jlee167/usb-cam-schematic/guardianCam_Wifi.kicad_pcb

## KiCad design guardianCam_Wifi.kicad_pcb (2021-04-28)

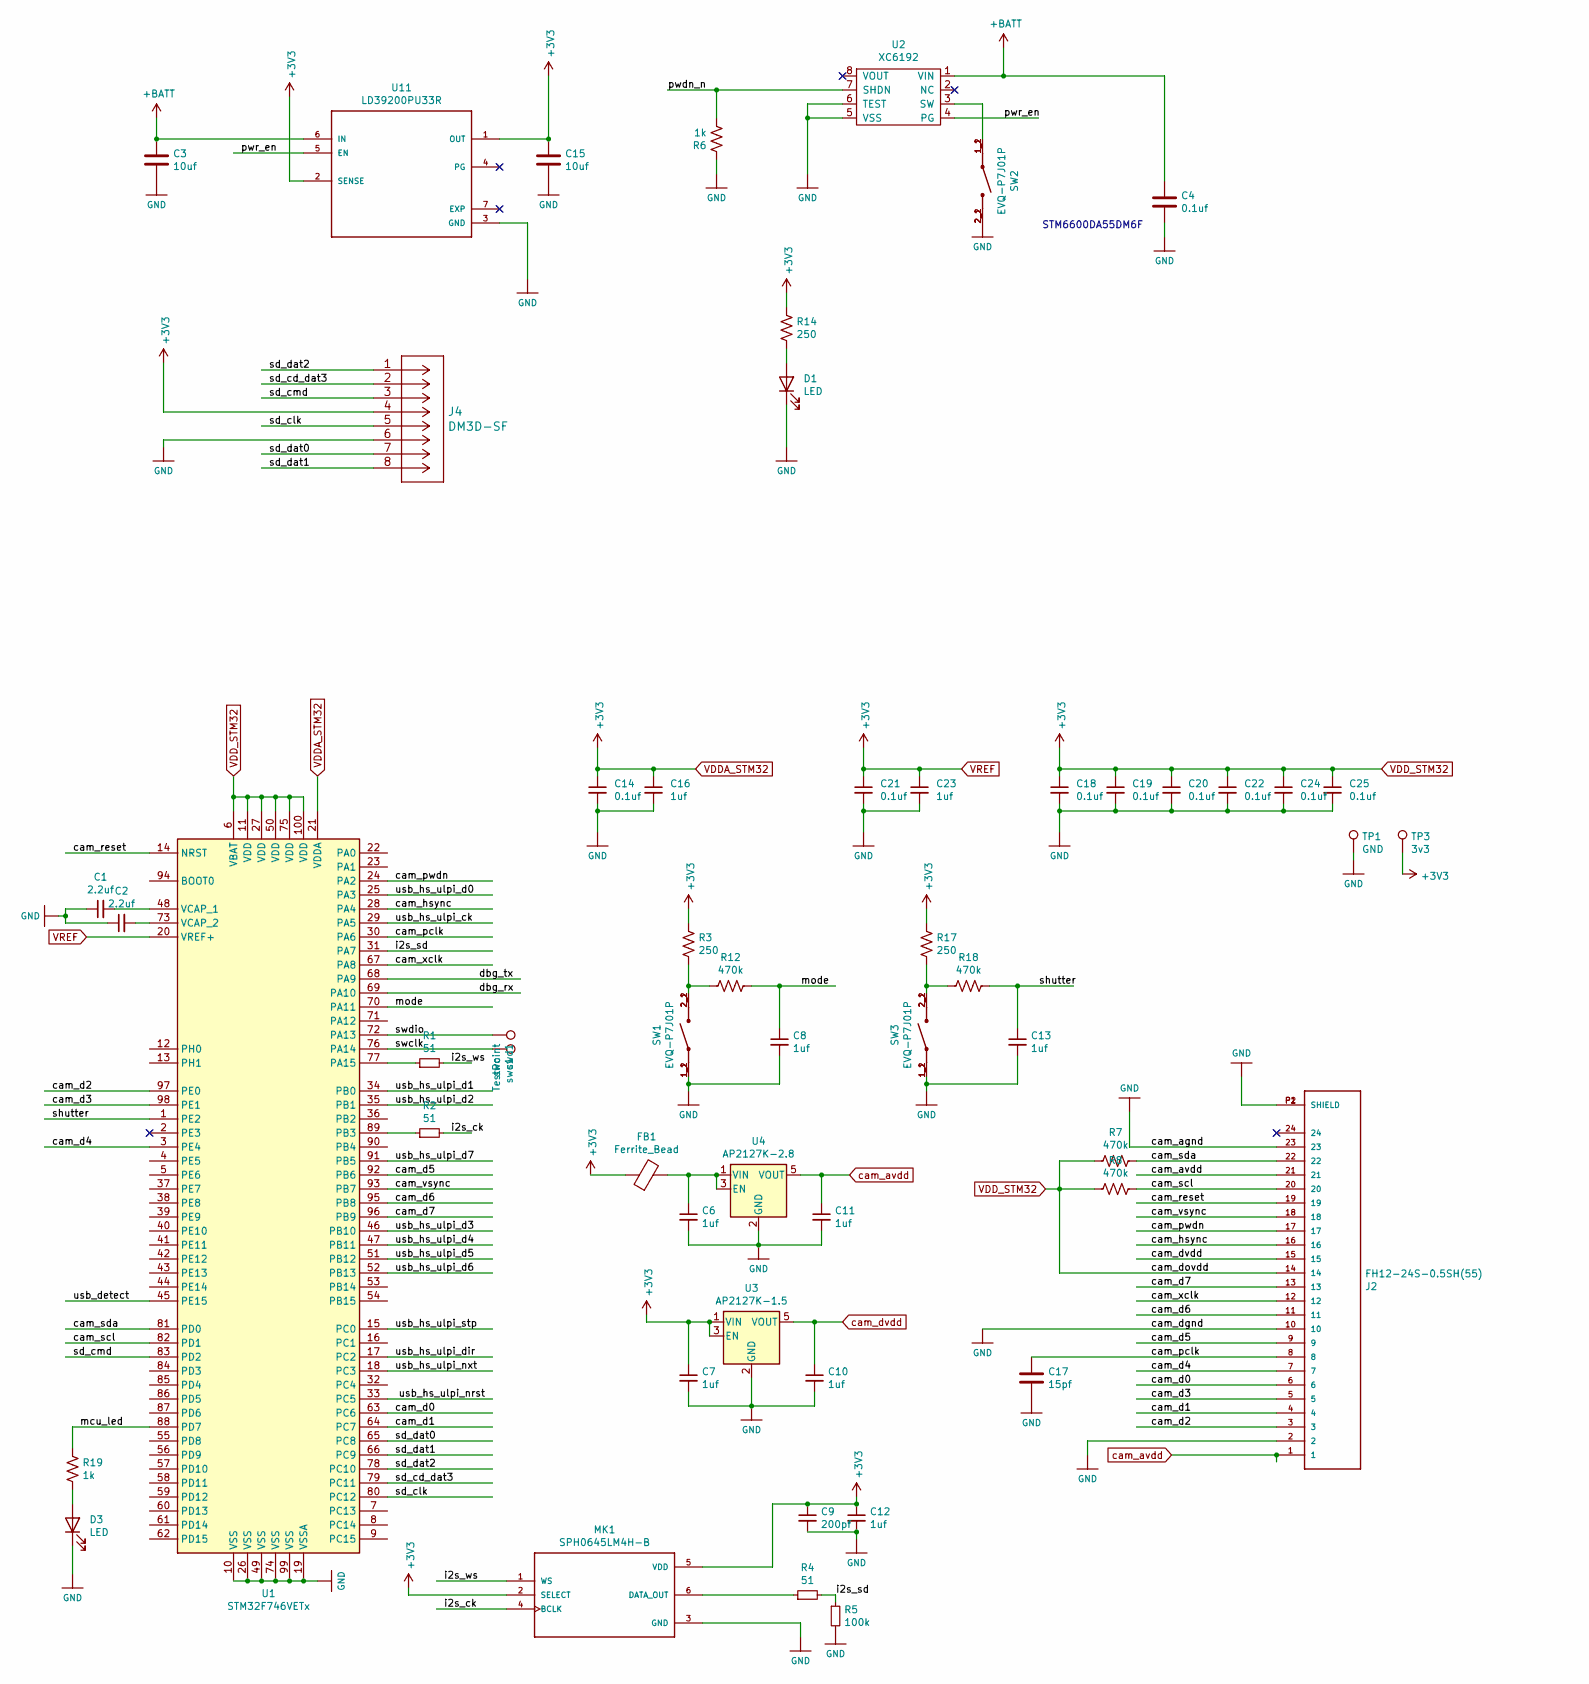
[picture p1: schematic guardianCam_Wifi.sch, part in row 1, column 1]

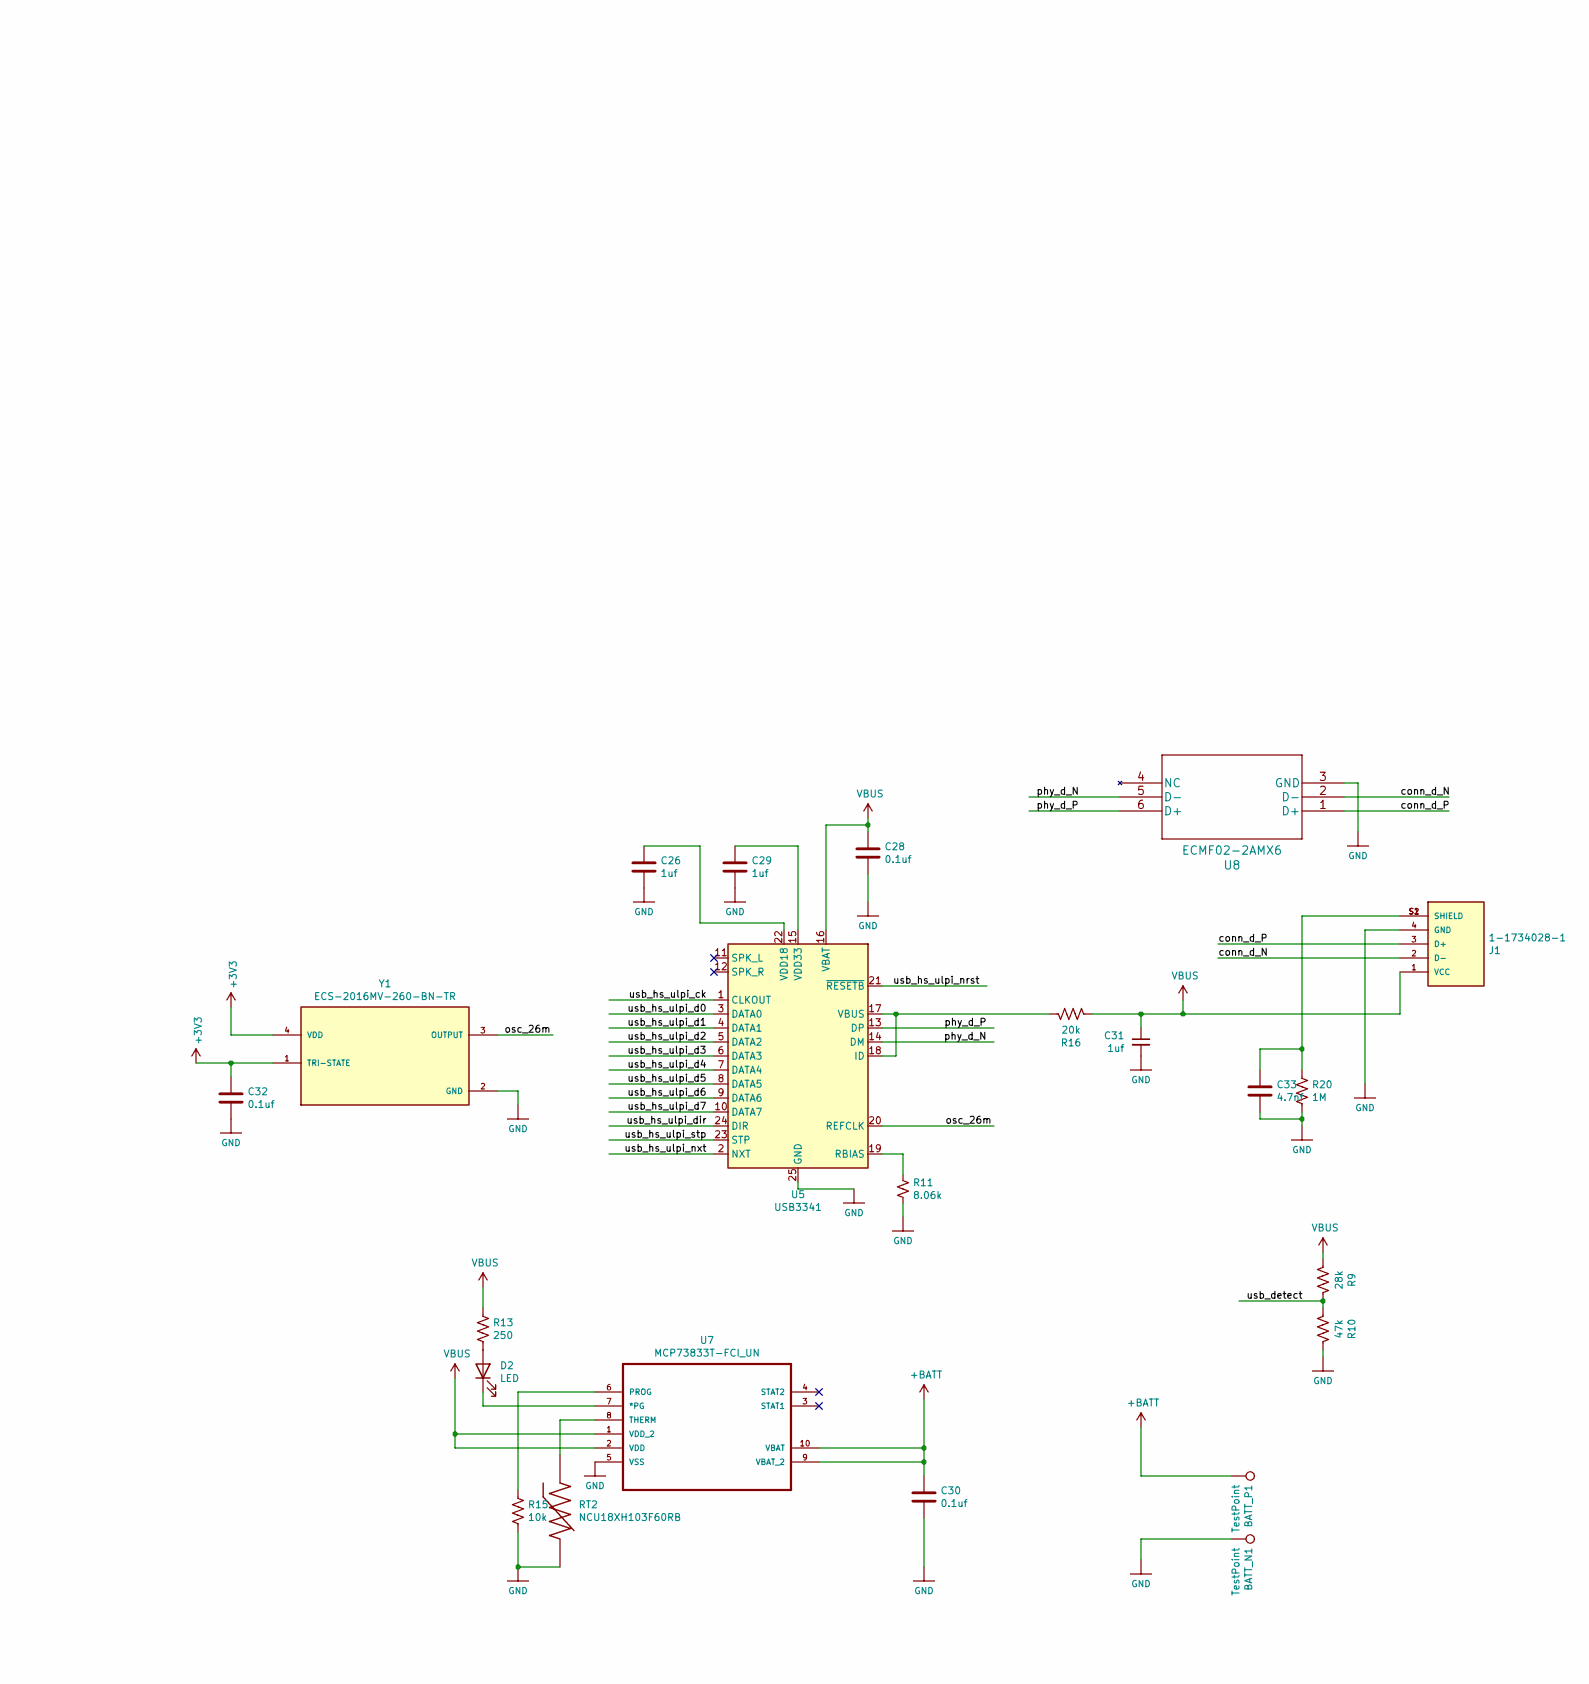
[picture p2: schematic guardianCam_Wifi.sch, part in row 1, column 2]

Parts:
BATT_N1: TestPoint; TestPoint_THTPad_1.0x1.0mm_Drill0.5mm
BATT_P1: TestPoint; TestPoint_THTPad_D1.0mm_Drill0.5mm
C1, C2: 2.2uf; C_0603_1608Metric_Pad1.05x0.95mm_HandSolder
C3, C15: 10uf; C_0603_1608Metric_Pad1.05x0.95mm_HandSolder
C4, C14, C18, C19, C20, C21, C22, C24, C25, C32: 0.1uf; C_0402_1005Metric
C6, C7, C8, C10, C11, C12, C13, C31: 1uf; C_0603_1608Metric_Pad1.05x0.95mm_HandSolder
C9: 200pf; C_0603_1608Metric_Pad1.05x0.95mm_HandSolder
C16, C23, C26, C29: 1uf; C_0402_1005Metric
C17: 15pf; C_0603_1608Metric_Pad1.05x0.95mm_HandSolder
C28: 0.1uf; C_0603_1608Metric_Pad1.05x0.95mm_HandSolder
C30: 0.1uf; C_0805_2012Metric_Pad1.15x1.40mm_HandSolder
C33: 4.7nf; C_0402_1005Metric
D1, D2, D3: LED; LED_0402_1005Metric
FB1: Ferrite_Bead; FB_MPZ2012S601ATD25
J1: 1-1734028-1; TE_1-1734028-1
J2: FH12-24S-0.5SH(55); HRS_FH12-24S-0.5SH(55)
J4: DM3D-SF
MK1: SPH0645LM4H-B; MIC_SPH0645LM4H-B
R1: 51; R_0402_1005Metric
R2, R4: 51; R_0603_1608Metric_Pad1.05x0.95mm_HandSolder
R3, R17: 250; R_0603_1608Metric_Pad1.05x0.95mm_HandSolder
R5: 100k; R_0603_1608Metric_Pad1.05x0.95mm_HandSolder
R6, R19: 1k; R_0402_1005Metric
R7, R8, R12, R18: 470k; R_0603_1608Metric_Pad1.05x0.95mm_HandSolder
R9: 28k; R_0603_1608Metric_Pad1.05x0.95mm_HandSolder
R10: 47k; R_0603_1608Metric_Pad1.05x0.95mm_HandSolder
R11: 8.06k; R_0402_1005Metric
R13, R14: 250; R_0402_1005Metric
R15: 10k; R_0402_1005Metric
R16: 20k; R_0603_1608Metric_Pad1.05x0.95mm_HandSolder
R20: 1M; R_0402_1005Metric
RT2: NCU18XH103F60RB
SW1, SW2, SW3: EVQ-P7J01P
TP1: GND; TestPoint_Pad_1.5x1.5mm
TP3: 3v3; TestPoint_Pad_1.5x1.5mm
U1: STM32F746VETx; LQFP-100_14x14mm_P0.5mm
U2: XC6192; xc6192
U3: AP2127K-1.5; SOT-23-5
U4: AP2127K-2.8; SOT-23-5
U5: USB3341; QFN-24-1EP_4x4mm_P0.5mm_EP2.6x2.6mm
U7: MCP73833T-FCI_UN
U8: ECMF02-2AMX6
U11: LD39200PU33R
Y1: ECS-2016MV-260-BN-TR; OSC_ECS-2016MV-260-BN-TR
swc1: swc; TestPoint_Pad_1.5x1.5mm
swd1: TestPoint; TestPoint_Pad_1.5x1.5mm

Connections:
+BATT: BATT_P1.1, C3.1, C4.1, C30.1, U2.1 (VIN), U7.9 (VBAT_2), U7.10 (VBAT), U11.6 (IN)
/cam_d0: J2.6, U1.63 (PC6)
/cam_d1: J2.4, U1.64 (PC7)
/cam_d2: J2.3, U1.97 (PE0)
/cam_d3: J2.5, U1.98 (PE1)
/cam_d4: J2.7, U1.3 (PE4)
/cam_d5: J2.9, U1.92 (PB6)
/cam_d6: J2.11, U1.95 (PB8)
/cam_d7: J2.13, U1.96 (PB9)
/cam_hsync: J2.16, U1.28 (PA4)
/cam_pclk: C17.1, J2.8, U1.30 (PA6)
/cam_pwdn: J2.17, U1.24 (PA2)
/cam_reset: J2.19, U1.14 (NRST)
/cam_scl: J2.20, R8.1, U1.82 (PD1)
/cam_sda: J2.22, R7.1, U1.81 (PD0)
/cam_vsync: J2.18, U1.93 (PB7)
/cam_xclk: J2.12, U1.67 (PA8)
/conn_d_N: J1.2 (D-), U8.2 (D-)
/conn_d_P: J1.3 (D+), U8.1 (D+)
/i2s_ck: MK1.4 (BCLK), R2.2
/i2s_sd: R4.2, R5.1, U1.31 (PA7)
/i2s_ws: MK1.1 (WS), R1.2
/mcu_led: R19.1, U1.88 (PD7)
/mode: C8.1, R12.1, U1.70 (PA11)
/osc_26m: U5.20 (REFCLK), Y1.3 (OUTPUT)
/phy_d_N: U5.14 (DM), U8.5 (D-)
/phy_d_P: U5.13 (DP), U8.6 (D+)
/pwdn_n: R6.2, U2.7 (SHDN)
/pwr_en: U2.4 (PG), U11.5 (EN)
/sd_cd_dat3: J4.2, U1.79 (PC11)
/sd_clk: J4.5, U1.80 (PC12)
/sd_cmd: J4.3, U1.83 (PD2)
/sd_dat0: J4.7, U1.65 (PC8)
/sd_dat1: J4.8, U1.66 (PC9)
/sd_dat2: J4.1, U1.78 (PC10)
/shutter: C13.1, R18.1, U1.1 (PE2)
/swclk: U1.76 (PA14), swc1.1
/swdio: U1.72 (PA13), swd1.1
/usb_detect: R9.2, R10.1, U1.45 (PE15)
/usb_hs_ulpi_ck: U1.29 (PA5), U5.1 (CLKOUT)
/usb_hs_ulpi_d0: U1.25 (PA3), U5.3 (DATA0)
/usb_hs_ulpi_d1: U1.34 (PB0), U5.4 (DATA1)
/usb_hs_ulpi_d2: U1.35 (PB1), U5.5 (DATA2)
/usb_hs_ulpi_d3: U1.46 (PB10), U5.6 (DATA3)
/usb_hs_ulpi_d4: U1.47 (PB11), U5.7 (DATA4)
/usb_hs_ulpi_d5: U1.51 (PB12), U5.8 (DATA5)
/usb_hs_ulpi_d6: U1.52 (PB13), U5.9 (DATA6)
/usb_hs_ulpi_d7: U1.91 (PB5), U5.10 (DATA7)
/usb_hs_ulpi_dir: U1.17 (PC2), U5.24 (DIR)
/usb_hs_ulpi_nrst: U1.33 (PC5), U5.21 (~RESETB)
/usb_hs_ulpi_nxt: U1.18 (PC3), U5.2 (NXT)
/usb_hs_ulpi_stp: U1.15 (PC0), U5.23 (STP)
GND: BATT_N1.1, C1.1, C2.1, C3.2, C4.2, C6.2, C7.2, C8.2, C9.2, C10.2, C11.2, C12.2, C13.2, C14.2, C15.2, C16.2, C17.2, C18.2, C19.2, C20.2, C21.2, C22.2, C23.2, C24.2, C25.2, C26.2, C28.2, C29.2, C30.2, C31.2, C32.2, C33.2, D1.1 (K), D3.1 (K), J1.4 (GND), J2.2, J2.10, J2.23, J2.P1 (SHIELD), J2.P2 (SHIELD), J4.6, MK1.3 (GND), R5.2, R6.1, R10.2, R11.2, R15.2, R20.2, RT2.2, SW1.1_1, SW1.1_2, SW2.2_1, SW2.2_2, SW3.1_1, SW3.1_2, TP1.1, U1.10 (VSS), U1.19 (VSSA), U1.26 (VSS), U1.49 (VSS), U1.74 (VSS), U1.99 (VSS), U2.5 (VSS), U2.6 (TEST), U3.2 (GND), U4.2 (GND), U5.25 (GND), U7.5 (VSS), U8.3 (GND), U11.3 (GND), Y1.2 (GND); also elsewhere on the board
unnamed: C1.2, U1.48 (VCAP_1)
unnamed: C2.2, U1.73 (VCAP_2)
unnamed: C6.1, FB1.2, U4.1 (VIN), U4.3 (EN)
unnamed: C26.1, U5.22 (VDD18)
unnamed: C29.1, U5.15 (VDD33)
unnamed: C33.1, J1.S1 (SHIELD), J1.S2 (SHIELD), R20.1
unnamed: D1.2 (A), R14.2
unnamed: D2.1 (K), U7.7 (*PG)
unnamed: D2.2 (A), R13.2
unnamed: D3.2 (A), R19.2
unnamed: MK1.6 (DATA_OUT), R4.1
unnamed: R1.1, U1.77 (PA15)
unnamed: R2.1, U1.89 (PB3)
unnamed: R11.1, U5.19 (RBIAS)
unnamed: R3.2, R12.2, SW1.2_1, SW1.2_2
unnamed: R15.1, U7.6 (PROG)
unnamed: R16.2, U5.17 (VBUS), U5.18 (ID)
unnamed: R17.2, R18.2, SW3.2_1, SW3.2_2
unnamed: RT2.1, U7.8 (THERM)
unnamed: SW2.1_1, SW2.1_2, U2.3 (SW)
VBUS: C28.1, C31.1, J1.1 (VCC), R9.1, R13.1, R16.1, U5.16 (VBAT), U7.1 (VDD_2), U7.2 (VDD)
VDDA_STM32: C7.1, C9.1, C12.1, C14.1, C15.1, C16.1, C18.1, C19.1, C20.1, C21.1, C22.1, C23.1, C24.1, C25.1, C32.1, FB1.1, J2.14, J4.4, MK1.2 (SELECT), MK1.5 (VDD), R3.1, R7.2, R8.2, R14.1, R17.1, TP3.1, U1.6 (VBAT), U1.11 (VDD), U1.20 (VREF+), U1.21 (VDDA), U1.27 (VDD), U1.50 (VDD), U1.75 (VDD), U1.100 (VDD), U3.1 (VIN), U3.3 (EN), U11.1 (OUT), U11.2 (SENSE), Y1.1 (TRI-STATE), Y1.4 (VDD); also elsewhere on the board
cam_avdd: C11.1, J2.1, J2.21, U4.5 (VOUT)
cam_dvdd: C10.1, J2.15, U3.5 (VOUT)

Notes on the sheet:
STM6600DA55DM6F

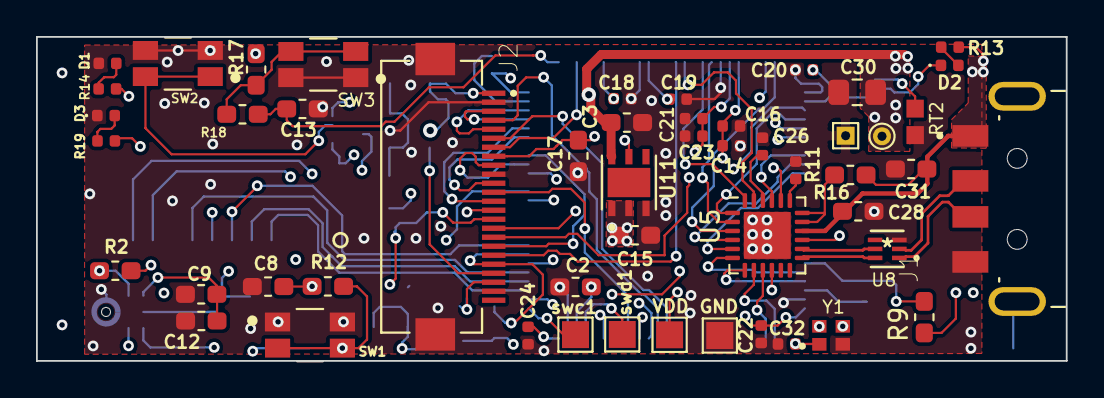
[picture p3: board guardianCam_Wifi.kicad_pcb from above]

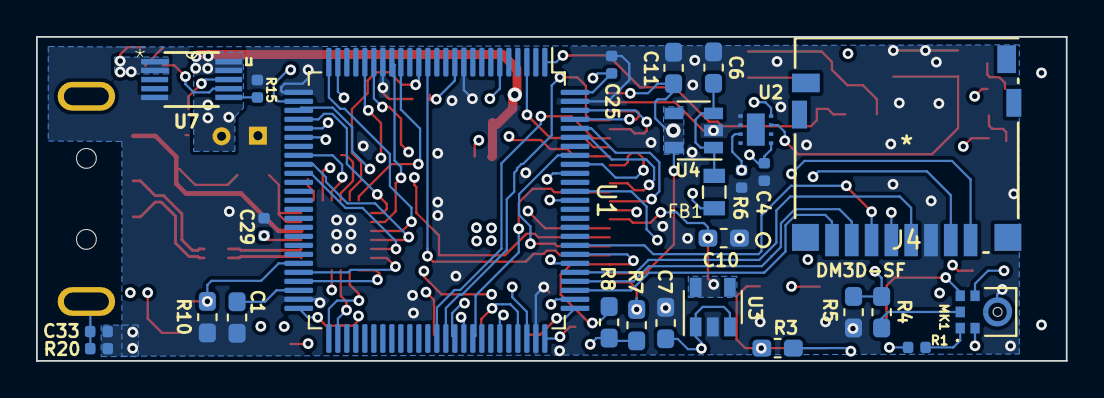
[picture p4: board guardianCam_Wifi.kicad_pcb from below]

Board: 4 copper layers, 57.2 x 18.0 mm, 78 parts (27 on the bottom side), 77 nets.

Other parts of the board:
GND: GND; TestPoint_Pad_1.5x1.5mm
VDD: 3v3; TestPoint_Pad_1.5x1.5mm

Their connections:
GND: GND.1; also elsewhere on the board
VDDA_STM32: VDD.1; also elsewhere on the board
